jprx/pretty-secure-processor/images/memory.png

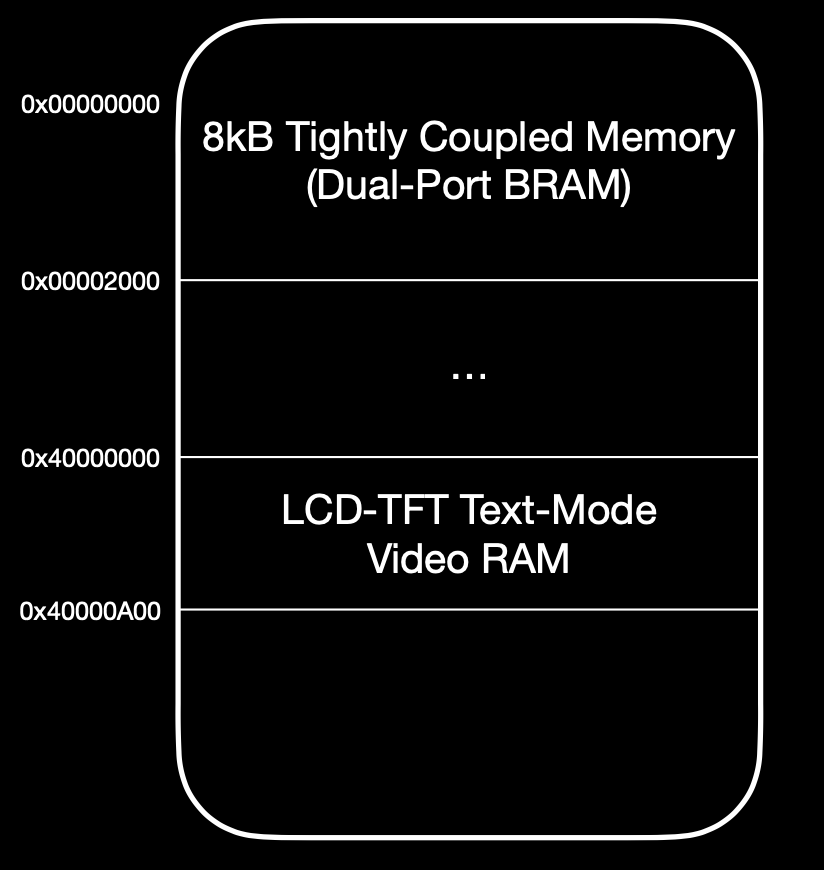
images/memory.png
