jprx/pretty-secure-processor/hdl/alu.sv

`include "defines.sv"

module alu
    (
        input logic[31:0] in1, in2,
        input logic[2:0] command, // Can't use input of enum type in Vivado so just inputting a logic[2:0]
        output logic[31:0] alu_out
    );

    // alu_out = in1 OPERATOR in2

    // Calculate alu_out = in1 OPERATOR in2
    always_comb begin
        case(alu_cmd'(command))
            alu_add     :   alu_out = in1 + in2;
            alu_sll     :   alu_out = in1 << (in2[4:0]);
            alu_sra     :   alu_out = $signed(in1) >>> (in2[4:0]); // Triple > operator is logical shift for signed types
            alu_sub     :   alu_out = in1 - in2;
            alu_xor     :   alu_out = in1 ^ in2;
            alu_srl     :   alu_out = in1 >> (in2[4:0]);
            alu_or      :   alu_out = in1 | in2;
            alu_and     :   alu_out = in1 & in2;
        endcase
    end

endmodule // alu

module cmp
    (
        input logic[31:0] in1, in2,
        input logic[2:0] command, // Can't use input of enum type in Vivado so just inputting a logic[2:0]
        output logic cmp_out
    );

    always_comb begin
        case(cmp_cmd'(command))
            cmp_lt      :   cmp_out = $signed(in1) < $signed(in2);
            cmp_ltu     :   cmp_out = in1 < in2;
            cmp_ge      :   cmp_out = in1 >= in2;
            cmp_geu     :   cmp_out = $signed(in1) >= $signed(in2);
            cmp_eq      :   cmp_out = in1 == in2;
            cmp_neq     :   cmp_out = in1 != in2;

            default     :   cmp_out = in1 == in2;
        endcase
    end

endmodule // cmp
