jprx/pretty-secure-processor/(commit log)

2020-12-07 Fix memory bugs and verify memory works
    [memory.sv, psp.sv, tb_memory.sv]
2020-12-07 Decode stage done
2020-12-11 Mem stage
2020-12-11 Testcode generation infra + test case 1
2020-12-11 Fix testcode endianness and a few decode bugs
    [defines.sv, memory.sv]
2020-12-11 Refactored stage transitions
2020-12-11 Fix bug in decode where addi was being decoded to subi, add branching
    [memory.sv]
2020-12-11 Hazards and stalling fixed and completely working
2020-12-12 Fix stalled fetch returning wrong instruction
2020-12-12 Fix misaligned memory writes and reads
    [defines.sv, psp.sv]
2020-12-12 Fix bug in toolchain, la pseudo-op now works
    [memory.sv, tb_psp.sv]
2020-12-13 Move hazard stall detection to decode, add WB->Decode hazard detection
2020-12-13 Fix synthesis bugs, meet timing by running core at 1/4 sysclk
    [psp.sv]
2020-12-13 Improve timing worst case slack by removing critical path
2020-12-13 Remove critical path from decode hazard reg by making stalls combinatorial
2020-12-16 Fix timings on TFT-LCD Controller
    [constraints.xdc, tb_psp.sv, tft.sv]
2020-12-16 Attach psp processor to LCD-TFT driver
2020-12-16 Fix simulation timing for generated clock
    [psp.sv, tb_psp.sv]
2020-12-21 Add memory initialization files, fix kernel buffer overrun, fix TFT pipeline timing, and fix return address HMAC signing incorrect value
    [memory.sv, psp.sv, tft.sv]
